mwedmark/KungFuFlash/pics/KungFuFlash.pptx

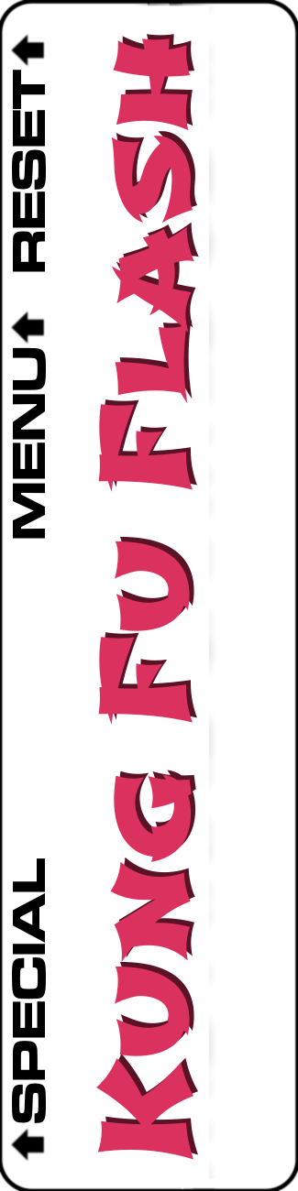
[picture p1: figure]
