mwedmark/KungFuFlash/PCB files/KungFuFlash-rev3-JLCPCB-smtproduction/KungFuFlash-rev3-bom-jlcpcb.xlsx

Comment | Designator | Footprint | JLCPCB Part #（optional）
 | U3 | LQFP-64_10.0x10.0x0.5P | C15742
 | Y1 | SMD-5032_2P | C115962
 | C17,C16,C15,C3,C4,C5,C6,C9,C10,C14,C13 | 0603 | C14663
 | C7,C8 | 0603 | C1648
 | C2,C1 | 0805 | C15850
 | C11,C12 | 0805 | C49217
 | D1 | LED_0805 | C2297
 | U2 | SOT-223 | C6186
 | Q1 | SOT-23-3 | C8589
 | R1,R4,R5,R6 | 0805 | C17734
 | R2,R3 | 0805 | C17414
 | RN1,RN2 | 0603_x4 | C25506
 | J2 | microUSB-B-conn | C10418
 | XS1 | mSD conn | C91145
 | SW1 | SW_PUSH_6mmx6mmxH5mm | C620202
 | SW2 | SW_PUSH_6mmx6mmxH5mm | C620202
 | SW3 | SW_PUSH_6mmx6mmxH5mm | C620202
