mwedmark/KungFuFlash/hardware/KungFuFlash.kicad_pcb

## KiCad design hardware/KungFuFlash.kicad_pcb (2023-02-15)

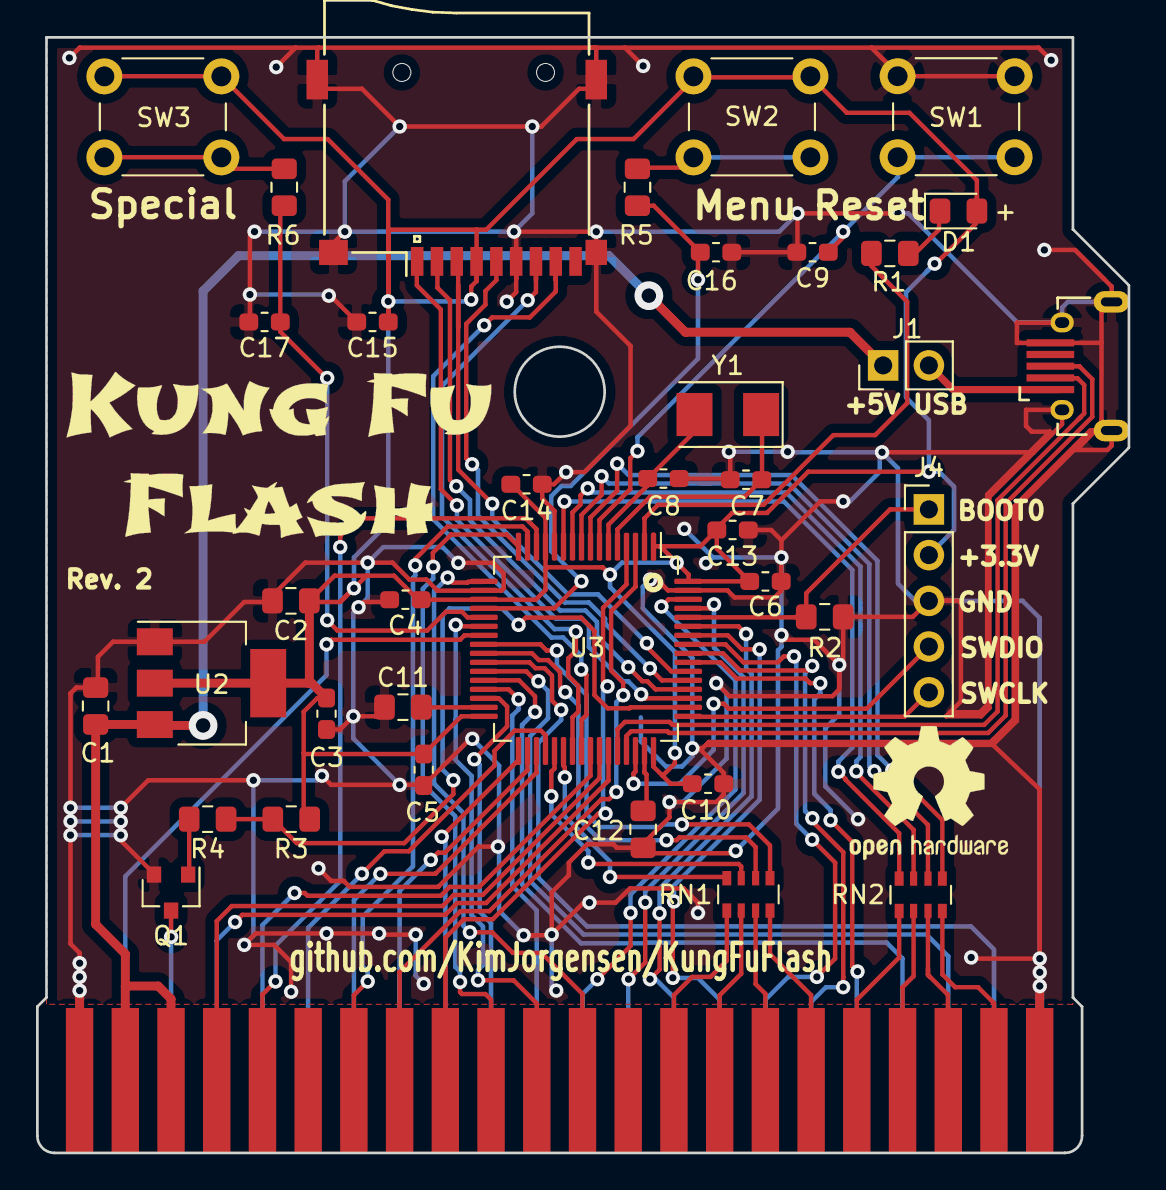
[picture p2: board KungFuFlash.kicad_pcb from above]

Board: 2 copper layers, 60.6 x 62.0 mm, 38 parts (0 on the bottom side), 72 nets.

Parts:
C1, C2: 10u; C_0805_2012Metric_Pad1.15x1.40mm_HandSolder
C3, C4, C5, C6, C9, C10, C13, C14, C15, C16, C17: 100n; C_0603_1608Metric_Pad1.05x0.95mm_HandSolder
C7, C8: 20p; C_0603_1608Metric_Pad1.05x0.95mm_HandSolder
C11, C12: 2.2u; C_0805_2012Metric_Pad1.15x1.40mm_HandSolder
D1: LED; LED_0805_2012Metric_Pad1.15x1.40mm_HandSolder
J1: USB Power; PinHeader_1x02_P2.54mm_Vertical
J2: USB_B_Micro; Conn_USBmicro-B_ebay-side_TH
J4: SWD; PinHeader_1x05_P2.54mm_Vertical
Q1: BC817; SOT-23
R1, R4, R5, R6: 510R; R_0805_2012Metric_Pad1.15x1.40mm_HandSolder
R2, R3: 10k; R_0805_2012Metric_Pad1.15x1.40mm_HandSolder
RN1, RN2: 100R; R_Array_Convex_4x0603
SW1: Reset; SW_PUSH_6mm_H8mm
SW2: Menu; SW_PUSH_6mm_H8mm
SW3: Special; SW_PUSH_6mm_H8mm
U1: C64-Exp-Port; C64-Cart
U2: AMS1117-3.3; SOT-223-3_TabPin2
U3: STM32F405RGTx; LQFP-64_10x10mm_P0.5mm
XS1: uSD_push_push; Conn_uSDcard
Y1: 8MHz; Crystal_SMD_5032-2Pin_5.0x3.2mm

Connections:
+3V3: C2.1, C3.1, C4.1, C5.1, C6.1, C10.1, C13.1, C14.1, C15.1, D1.2, J4.2, R3.1, SW2.1, SW3.1, U2.2, U3.1, U3.13, U3.19, U3.32, U3.48, U3.64, XS1.4
+5C: J1.2, J2.1
+5V: C1.1, J1.1, U1.2, U1.3, U2.3
/A0: U1.Y, U3.26
/A1: U1.X, U3.27
/A2: U1.W, U3.28
/A3: U1.V, U3.55
/A4: U1.U, U3.56
/A5: U1.T, U3.57
/A6: U1.S, U3.58
/A7: U1.R, U3.59
/A8: U1.P, U3.61
/A9: U1.N, U3.62
/A10: U1.M, U3.29
/A11: U1.L, U3.30
/A12: U1.K, U3.33
/A13: U1.J, U3.34
/A14: U1.H, U3.35
/A15: U1.F, U3.36
/BA: U1.12, U3.17
/BOOT0: J4.1, R2.1, U3.60
/CD0: RN2.4, U1.21
/CD1: RN2.3, U1.20
/CD2: RN2.2, U1.19
/CD3: RN2.1, U1.18
/CD4: RN1.4, U1.17
/CD5: RN1.3, U1.16
/CD6: RN1.2, U1.15
/CD7: RN1.1, U1.14
/D0: RN2.5, U3.8
/D1: RN2.6, U3.9
/D2: RN2.7, U3.10
/D3: RN2.8, U3.11
/D4: RN1.5, U3.24
/D5: RN1.6, U3.25
/D6: RN1.7, U3.37
/D7: RN1.8, U3.38
/MENU: C16.1, R5.2, U3.20
/PHI2: U1.E, U3.41
/R~W: U1.5, U3.14
/SD_CK: U3.53, XS1.5
/SD_CMD: U3.54, XS1.3
/SD_D0: U3.39, XS1.7
/SD_D1: U3.40, XS1.8
/SD_D2: U3.51, XS1.1
/SD_D3: U3.52, XS1.2
/SPECIAL: C17.1, R6.2, U3.21
/SWCLK: J4.5, U3.49
/SWDIO: J4.4, U3.46
/USB_DM: J2.2, U3.44
/USB_DP: J2.3, U3.45
/~EXROM: U1.9, U3.4
/~GAME: U1.8, U3.3
/~IO1: U1.7, U3.15
/~IO2: U1.10, U3.16
/~IRQ: U1.4, U3.42
/~LED: R1.1, U3.2
/~NMI: U1.D, U3.43
/~RESET: Q1.3, U1.C
/~ROMH: U1.B, U3.23
/~ROML: U1.11, U3.22
/~RST_O: R3.2, R4.2, U3.50
/~RST: C9.1, SW1.2, U3.7
GND: C1.2, C2.2, C3.2, C4.2, C5.2, C6.2, C7.1, C8.2, C9.2, C10.2, C11.1, C12.2, C13.2, C14.2, C15.2, C16.2, C17.2, J2.5, J2.6, J4.3, Q1.2, R2.2, SW1.1, U1.1, U1.22, U1.A, U1.Z, U2.1, U3.12, U3.18, U3.63, XS1.6
unnamed: C7.2, U3.5, Y1.1
unnamed: C8.1, U3.6, Y1.2
unnamed: C11.2, U3.31
unnamed: C12.1, U3.47
unnamed: D1.1, R1.2
unnamed: Q1.1, R4.1
unnamed: R5.1, SW2.2
unnamed: R6.1, SW3.2
