mwedmark/KungFuFlash/firmware/sidasm.h

int SidDataSize = 269;
char SidData[] = {
0x01,0x08,0x0B,0x08,0x0A,0x00,0x9E,0x32,0x30,0x36,0x31,0x00,0x00,0x00,0x20,0x6B,
0x08,0x20,0xB1,0x08,0xA9,0x25,0x78,0xD8,0xA2,0x2F,0x86,0x00,0x85,0x01,0xA9,0x7F,
0x8D,0x0D,0xDC,0x8D,0x0D,0xDD,0x2D,0x11,0xD0,0x8D,0x11,0xD0,0xAD,0x0D,0xDC,0xAD,
0x0D,0xDD,0xA9,0xFF,0x8D,0x19,0xD0,0xA9,0xDF,0xA2,0x08,0x8D,0xFE,0xFF,0x8E,0xFF,
0xFF,0xA9,0x01,0x8D,0x1A,0xD0,0xA9,0x08,0x48,0xA9,0x52,0xE9,0x01,0x48,0xA9,0x00,
0x6C,0x08,0x09,0xA9,0x5F,0x8D,0x12,0xD0,0xA9,0x01,0x8D,0x1A,0xD0,0xAD,0x0D,0xDC,
0xAD,0x0D,0xDD,0xA9,0xFF,0x8D,0x19,0xD0,0x58,0x4C,0x68,0x08,0xA9,0x00,0x85,0xAA,
0xA9,0x58,0x85,0xAB,0xA0,0x7C,0xA2,0x00,0xB1,0xAA,0x9D,0x06,0x09,0xC8,0xE8,0xB1,
0xAA,0x9D,0x06,0x09,0xA0,0x0A,0xA2,0x01,0xB1,0xAA,0x9D,0x08,0x09,0xCA,0xC8,0xB1,
0xAA,0x9D,0x08,0x09,0xA0,0x0C,0xA2,0x01,0xB1,0xAA,0x9D,0x0A,0x09,0xCA,0xC8,0xB1,
0xAA,0x9D,0x0A,0x09,0xA2,0x00,0xBD,0x06,0x09,0x85,0xAC,0xE8,0xBD,0x06,0x09,0x85,
0xAD,0x60,0xA0,0x00,0xA5,0xAA,0x69,0x7E,0x85,0xAA,0xB1,0xAA,0x91,0xAC,0xA5,0xAA,
0xC9,0x00,0xD0,0x06,0xA5,0xAB,0xC9,0x80,0xF0,0x06,0x20,0xD0,0x08,0x4C,0xB9,0x08,
0x60,0xA2,0x00,0xE6,0xAA,0xD0,0x02,0xE6,0xAB,0xE6,0xAC,0xD0,0x02,0xE6,0xAD,0x60,
0x48,0x8A,0x48,0x98,0x48,0xA9,0x01,0x8D,0x20,0xD0,0xA9,0x08,0x48,0xA9,0xF4,0xE9,
0x01,0x48,0x6C,0x0A,0x09,0xEA,0xA9,0x0E,0x8D,0x20,0xD0,0xA9,0x01,0x8D,0x19,0xD0,
0x68,0xA8,0x68,0xAA,0x68,0x40,0x00,0x00,0x00,0x00,0x00,0x00,0x00,};
